AlvaroPRuiiz/card_dealer/presentacion/ELCO-DEALER-v2-final.pptx

ELCO—

DEALER

Sistema Automático de Reparto de Cartas

ASIGNATURA ELCO · PROYECTO FINAL

♠

♦

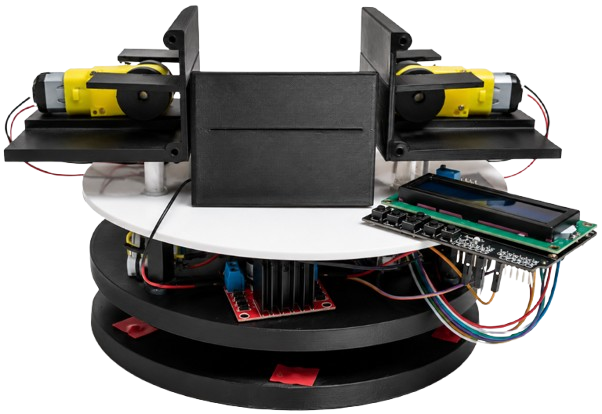
[picture p9: figure]

Álvaro Poveda

Carlos González

Itziar Otaño

Javier Carretero

♣

Cristina Rodríguez

Juan Salgado

♥

## Slide 2

¿POR QUÉ AUTOMATIZAR EL REPARTO Y EL BARAJADO?

TIEMPO PERDIDO

El reparto manual interrumpe el juego y alarga innecesariamente cada ronda.

LA SOLUCIÓN

ELCO-DEALER

▸ REPARTO Y BARAJADO 100% AUTOMÁTICO

▸ CONSISTENTE, RÁPIDO Y REPETIBLE

▸ SIN ERRORES DE DISTRIBUCIÓN

▸ EXPERIENCIA FLUIDA EN CADA PARTIDA

ERRORES DE DISTRIBUCIÓN

La repartición humana genera errores que ralentizan y enturbian la partida.

EXPERIENCIA DISCONTINUA

Detener el juego para repartir rompe el ritmo e inmersión del jugador.

## Slide 3

OBJETIVO Y FUNCIONALIDADES DEL SISTEMA

Diseñar e implementar un sistema electrónico capaz de repartir automáticamente cartas a N jugadores, de forma precisa, configurable y controlada por el usuario.

INTERFAZ PANTALLA

Menú interactivo con pantalla LCD y botonera integrada

REPARTO MANUAL

Control directo mediante pulsador para uso flexible

N JUGADORES

Número de participantes configurable desde la interfaz

RETORNO A REFERENCIA

Vuelta automática a posición inicial tras cada ciclo

VERIFICACIÓN SENSORES

Detección de carta entregada para validar cada reparto

REPARTO Y BARAJEO AUTOMÁTICO

Distribución carta a carta a cada jugador en orden de turno

## Slide 4

EVOLUCIÓN DEL PROYECTO

DISEÑO

SELECCIÓN DE IDEA

Evaluación de alternativas · elección del concepto

IMPLEMENTACIÓN Y VALIDACIÓN

CONTROL / FSM

Máquina de estados implementada en Arduino Mega

01

05

02

DISEÑO CONCEPTUAL

Definición de arquitectura, componentes y subsistemas

06

PRUEBAS DE SUBSISTEMAS

Validación individual: motores, sensores, interfaz

03

DISEÑO CAD / MECÁNICO

Modelado 3D en OnShape · piezas para impresión FDM

07

INTEGRACIÓN Y REDISEÑOS

Ensamblaje completo · correcciones iterativas

04

DISEÑO ELECTRÓNICO

Esquemáticos · selección de drivers, motores y sensores

08

VALIDACIÓN FINAL

Demo funcional completa · prototipo operativo

## Slide 5

DISEÑO MECÁNICO

DISEÑO CAD EN ONSHAPE

PIEZAS FDM · DISEÑO MODULAR

BASE, GIRO Y REPARTIDOR

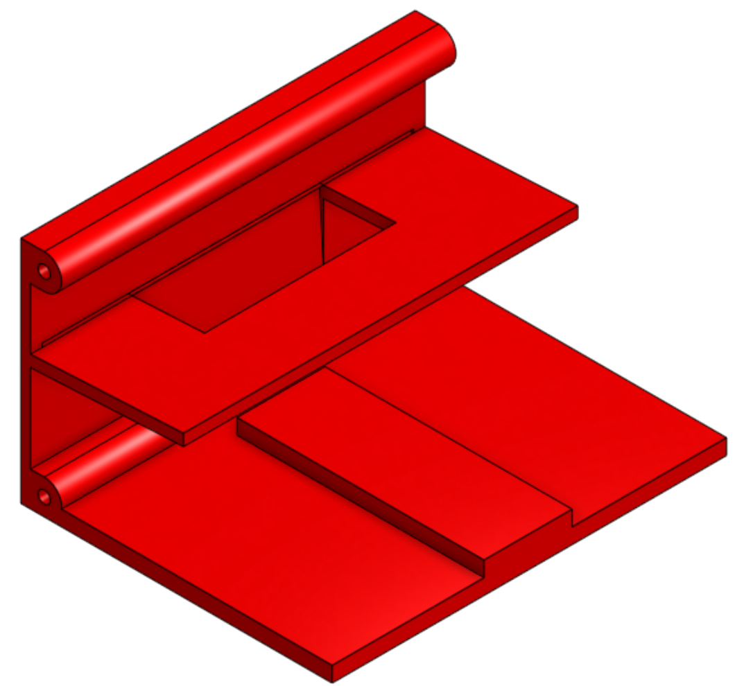
[picture p10: figure]

BARAJADOR / REPARTIDOR

Mecanismo principal

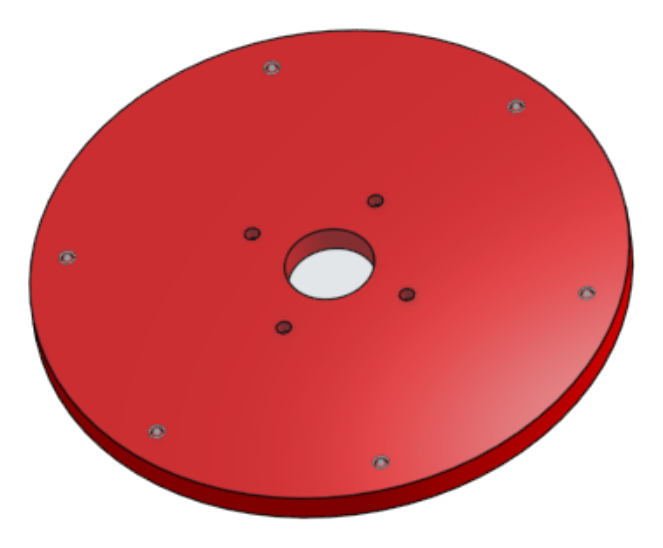
[picture p11: figure]

PLATO / DISCO

Base de giro

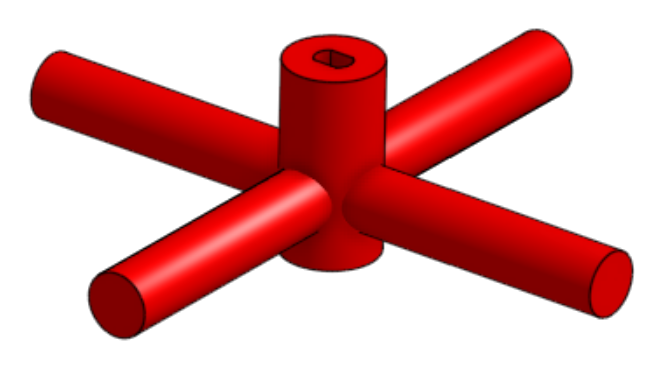
[picture p12: figure]

SOPORTE GIRATORIO

Lazy Susan CAD

## Slide 6

DISEÑO ELECTRÓNICO

ARDUINO MEGA

Controlador central

→

DRIVERS

L298N / A4988

→

MOTORES

Paso a paso / DC

→

SENSORES

Detección de carta

→

PANTALLA

LCD + botonera

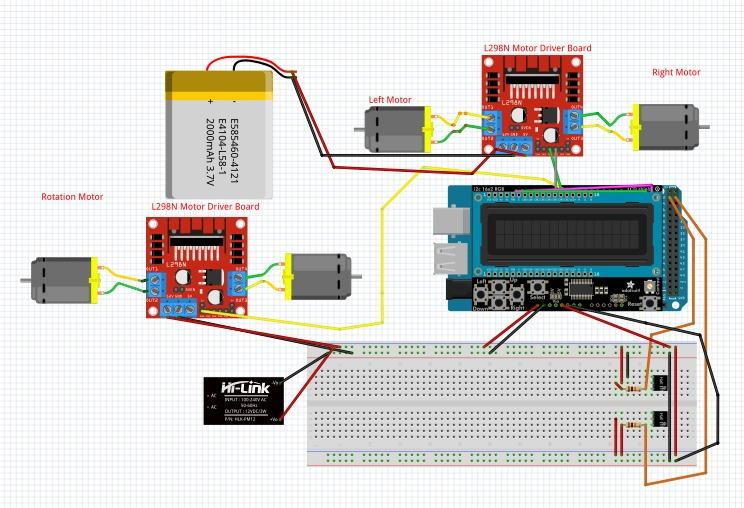
[picture p13: figure]
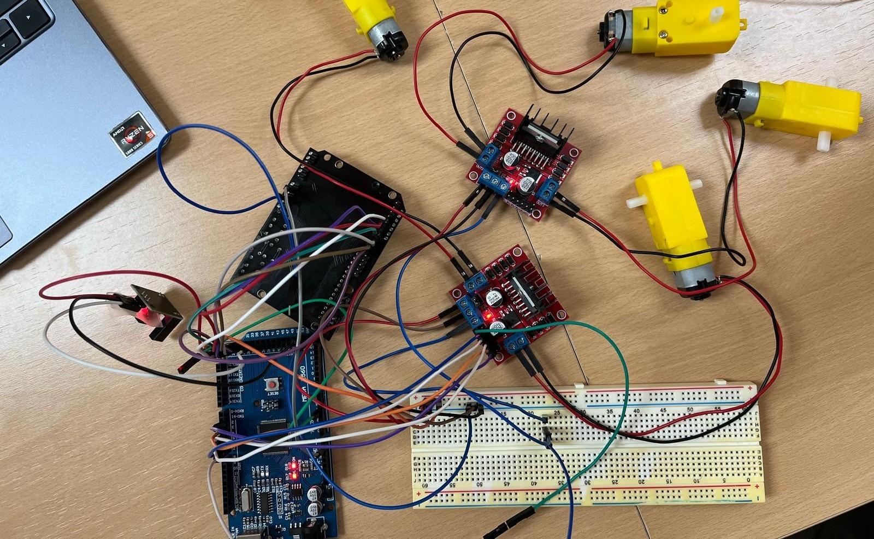
[picture p14: figure]

ESQUEMA INICIAL

Distribución base de conexiones

ESQUEMA FINAL

Versión completa con leyenda

CABLEADO REAL

Montaje físico del prototipo

Núcleo del proyecto: coordinación de motor paso a paso, sensor óptico, interfaz LCD y lógica de control en una arquitectura integrada sobre Arduino Mega.

## Slide 7

CONTROL DEL SISTEMA — FSM

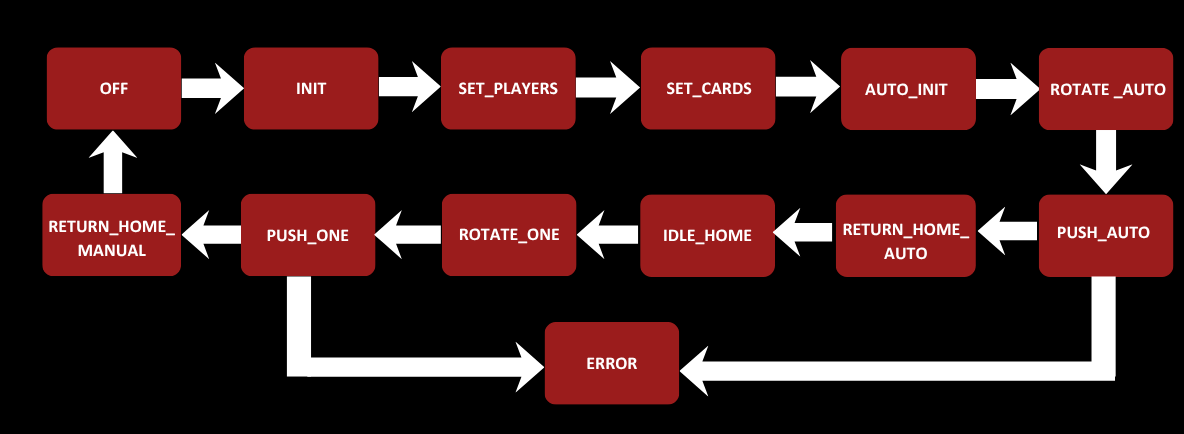
[picture p15: figure]

## Slide 8

FASES DE PRUEBA Y VALIDACIÓN

INTERFAZ DE USUARIO

Navegación LCD · Respuesta pulsadores · Configuración jugadores

FASE 1

✓ VALIDADO

SISTEMA DE SENSORES

Detección de carta · Umbral de sensibilidad · Falsos positivos

FASE 2

✓ VALIDADO

SISTEMA DE MOTORES

Control paso a paso · Velocidad de reparto · Posicionamiento angular

FASE 3

✓ VALIDADO

INTEGRACIÓN GLOBAL

Coordinación subsistemas · FSM ciclo completo · Pruebas de estrés

FASE 4

ERROR

VALIDACIÓN FINAL

Reparto completo N jugadores · Ciclos repetidos · Demo funcional grabada

FASE 5

ERROR

## Slide 9

EVALUACIÓN TÉCNICA DEL PROYECTO

CRITERIO

VALORACIÓN

OBSERVACIONES

DIFICULTAD DE DESARROLLO

⭐️⭐️⭐️⭐️⭐️

Integración mecánica + electrónica + software

CONSUMO ENERGÉTICO

⭐️

Estimado en pruebas de subsistema

COSTE DE PRODUCCIÓN

21,57€

Componentes COTS + impresión 3D

NIVEL DE ELECTRÓNICA

Alto

Arduino Mega + drivers + sensores + LCD

COMPLEJIDAD DE CONTROL

Alta — FSM implementada

Múltiples estados y transiciones condicionales

POSIBILIDAD DE ESCALADO

Alta

Más jugadores, más barajas, conectividad

EXPERIENCIA DE USUARIO

—

Evaluación durante la demo final

## Slide 10

DIFICULTADES Y FUTURAS IMPLEMENTACIONES

DIFICULTADES ENCONTRADAS

▸ Integración simultánea de subsistemas mecánicos y electrónicos

▸ Calibración de sensores ópticos para detección fiable de carta

▸ Sincronización de la FSM con los tiempos de actuación motora

FUTURAS IMPLEMENTACIONES

Conectividad inalámbrica — Integración Bluetooth o WiFi para control desde app móvil

Reconocimiento de juego — Adaptar el reparto automático a distintos tipos de juegos de cartas

Diseño de producto final — Reducción de coste y tamaño para versión comercializable

Escalado de jugadores — Ampliar el sistema para soportar configuraciones de más participantes

Integración de sensores — Sustituir la selección del número de jugadores y el sistema de imanes para el sensor home por sensores de cada jugador

## Slide 11

♠

♦

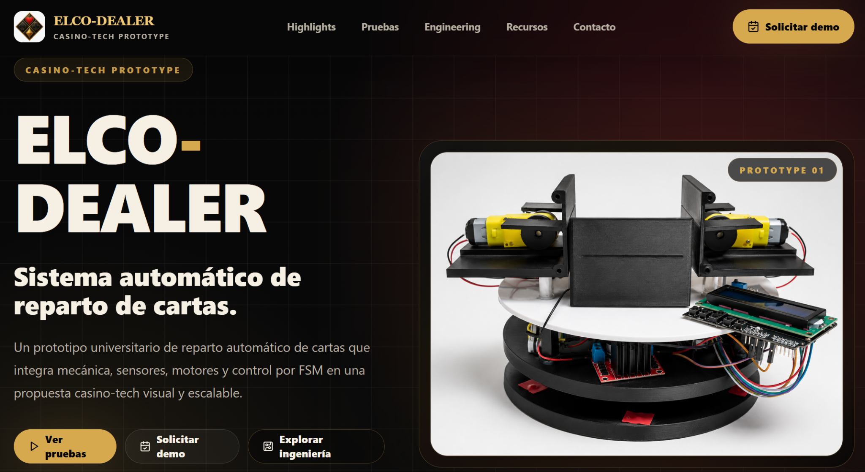
[picture p16: figure]

WEB (https://elco-dealer-web.netlify.app/)

♣

♥

## Slide 12

♠

♦

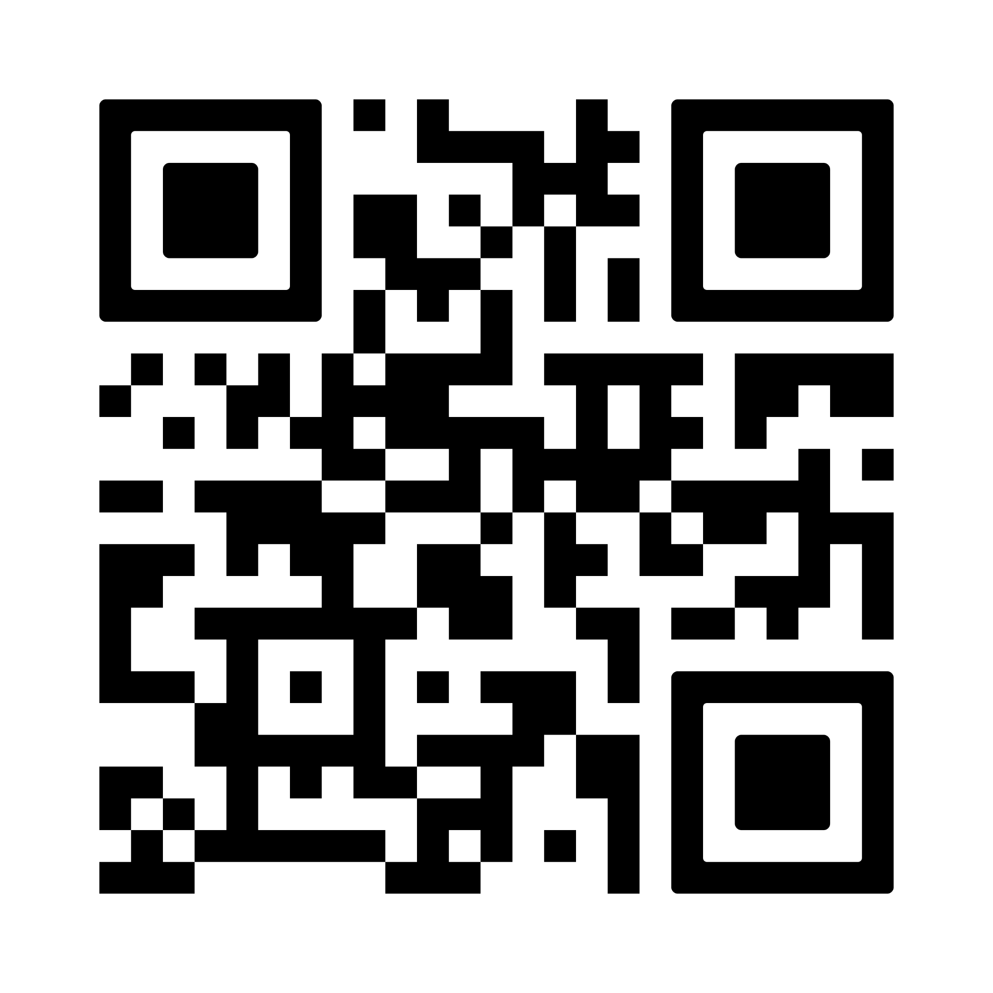
[picture p17: figure]

WEB (https://elco-dealer-web.netlify.app/)

♣

♥
