AlvaroPRuiiz/card_dealer/web/public/assets/README.md

# Assets públicos de ELCO-DEALER

La web referencia estos archivos:

- `logo_elco_dealer.svg`: fuente vectorial oficial del logo de la web.
- `logo_elco_dealer_primary.png`: PNG principal usado en navbar, footer y favicon.
- `logo_elco_dealer.png`: logo de documentación/respaldo legacy, conservado porque se usa también en los documentos.
- `manual_usuario.pdf`: manual descargable en `/recursos`.
- `guia_software.pdf`: guía de software descargable en `/recursos`.
- `montaje_hw.png`: imagen final del hardware para el hero. Pendiente de sustituir/añadir.
- `demo_video.mp4`: clip de pruebas parciales para home y `/recursos`. Pendiente de sustituir/añadir.

Cuando estén listos `montaje_hw.png` y `demo_video.mp4`, basta con colocarlos en
esta carpeta manteniendo esos nombres.
